PauLL54/PreamplifierAndMediaStreamer/Preamplifier.ino

// @title MIT License
//
//  Copyright © 2019 Paul Langemeijer. All rights reserved.
//
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
//  THE SOFTWARE IS PROVIDED "AS IS", WITHOUT WARRANTY OF ANY KIND, EXPRESS OR
//  IMPLIED, INCLUDING BUT NOT LIMITED TO THE WARRANTIES OF MERCHANTABILITY,
//  FITNESS FOR A PARTICULAR PURPOSE AND NONINFRINGEMENT. IN NO EVENT SHALL
//  THE AUTHORS OR COPYRIGHT HOLDERS BE LIABLE FOR ANY CLAIM, DAMAGES OR OTHER
//  LIABILITY, WHETHER IN AN ACTION OF CONTRACT, TORT OR OTHERWISE, ARISING
//  FROM, OUT OF OR IN CONNECTION WITH THE SOFTWARE OR THE USE OR OTHER
//  DEALINGS IN THE SOFTWARE.
#include <Wire.h>
#include "InputChannelSelector.h"
#include "InputChannelSelectButton.h"
#include "DigitalPotmeter.h"
#include "DigitalAttenuator.h"
#include "VolumeRotaryEncoder.h"
#include "IRCommands.h"
#include "SystemParameters.h"
#include "i2c.h"
#include "LightControl.h"
#include "OutputChannelSelector.h"

DigitalPotmeter m_digitalPotmeter;
DigitalAttenuator m_digitalAttenuator;
OutputChannelSelector m_outputChannelSelector(m_digitalAttenuator);
InputChannelSelector m_inputChannelSelector(m_digitalPotmeter, m_outputChannelSelector);
InputChannelSelectButton m_inputChannelSelectButton(m_inputChannelSelector);
VolumeRotaryEncoder m_volumeRotaryEncoder(m_digitalPotmeter);
IRCommands m_IRCommands(m_inputChannelSelector, m_digitalPotmeter);
I2C m_i2c(m_inputChannelSelector, m_digitalPotmeter, m_digitalAttenuator, m_outputChannelSelector, m_IRCommands);
LightControl m_lightControl(m_inputChannelSelectButton, m_volumeRotaryEncoder, m_IRCommands, m_digitalPotmeter, m_inputChannelSelector, m_i2c);

bool m_initializing = true;

#define INPUT_SIZE 30
void I2C_receiveEvent(int howMany)
{
  char input[INPUT_SIZE + 1];
  byte i = 0;
  while (Wire.available() > 0 && i < INPUT_SIZE)
  {
    char c = (char)Wire.read();
    input[i] = c;
    i++;
  }
  input[i] = (char)0;
  //Serial.println(input);
  m_i2c.handleInput(input);
}

void I2C_requestEvent()
{
  // send input channel (0..7), output channel (0..1), volume enabled for channel (byte: 0..255, each bit determines state of a channel), volume (0..31)
  char buf[20];
  sprintf(buf, "I=%d;O=%d;R=%3d;V=%2d;\0", 
    m_inputChannelSelector.getChannel(),  
    m_outputChannelSelector.getChannel(),
    m_IRCommands.getVolumeEnabledForChannel(),
    m_digitalPotmeter.getTargetValue());
    //Serial.println(buf);
    Wire.write(buf);
}

void setup()
{
  Serial.begin(9600);

  Wire.begin(4);                    // join i2c bus with address #4
  Wire.onReceive(I2C_receiveEvent); // register event
  Wire.onRequest(I2C_requestEvent);
}

void initializeDigitalPotmeters()
{
  m_digitalPotmeter.updateToTargetValue();
  m_digitalAttenuator.updateToTargetValue();
  if (m_digitalPotmeter.isInitialized())
  {
    m_initializing = false;
    m_digitalAttenuator.initChannelValues();
    m_digitalPotmeter.initChannelValues();

    m_inputChannelSelector.selectChannel(6);  // 0..7
    m_outputChannelSelector.selectChannel(0);  // 0..1
    m_outputChannelSelector.enableOutputs();
  }
}

void loop()
{
  if (m_initializing)
  {
    initializeDigitalPotmeters();
  }
  else
  {
    m_inputChannelSelectButton.checkButtonPressed();
    m_volumeRotaryEncoder.checkRotation();
    m_IRCommands.checkForCommands();
    m_digitalPotmeter.updateToTargetValue();
    m_digitalAttenuator.updateToTargetValue();
    m_lightControl.checkDisplaySwitchOffNeeded();
    m_inputChannelSelector.checkMuted();
  }
}
