PauLL54/PreamplifierAndMediaStreamer/InputChannelSelector.h

//  Copyright © 2019 Paul Langemeijer. All rights reserved.
#pragma once
#include "Debouncer.h"
#include "stdint.h"

class DigitalPotmeter;
class OutputChannelSelector;

class InputChannelSelector {
public:
	InputChannelSelector(DigitalPotmeter& digitalPotmeter, OutputChannelSelector& outputChannelSelector);

    int8_t getChannel();
	void selectChannel(int8_t channel); // 0..7
	void selectNextChannel();
	void selectPreviousChannel();
	void setDefaultBrightness(int8_t brightness);
	void enableDisplay();
	void disableDisplay();
	void checkMuted();

private:
	void setBrightness(int8_t brightness);
	void switchToChannel(int8_t channel);

private:
	DigitalPotmeter& m_digitalPotmeter;
	OutputChannelSelector& m_outputChannelSelector;
	int8_t m_brightness;
	int8_t m_currentChannel;
	unsigned long m_muteTimeOut;
};
