PauLL54/PreamplifierAndMediaStreamer/DigitalAttenuator.h

//  Copyright © 2019 Paul Langemeijer. All rights reserved.
#pragma once
#include "XicorX9514.h"

class DigitalAttenuator : public XicorX9514 {
public:
	DigitalAttenuator();

	void initChannelValues();
};
