PauLL54/PreamplifierAndMediaStreamer/(commit log)

2019-06-14 LedRing class
2019-06-17 Debouncer using millis()
2019-06-17 Keeping Led ring white
2019-06-17 LED ring green and white
2019-06-19 change pin led ring
2019-06-19 change bounce time encoder
2019-06-20 fix issue in debouncer
    [Debouncer.cpp, InputChannelSelectButton.cpp, VolumeRotaryEncoder.cpp]
2019-07-02 pin constants
2019-07-04 Enable output relay
2019-07-05 disable LED ring after 30 minutes
2019-11-02 Add support for I2C bus for version 2
2019-12-26 Shorten time light is on
    [LightControl.cpp]
2020-02-17 Prepare for PCB version 2
2020-03-08 Fix input selector LEDs display off
    [InputChannelSelector.cpp]
2020-03-10 Disable / enable display; prepare I2C
2020-03-11 I2C support LedBrightness
2020-07-21 I2C SetChannel
2020-07-24 LightControl adapted for I2C
2020-08-28 remove print statements
2020-09-02 support for diffrent rotary encoders
2020-10-01 fix issue in SCV command
    [InputChannelSelector.cpp, InputChannelSelector.h, OutputChannelSelector.cpp, OutputChannelSelector.h, Preamplifier.ino, XicorX9514.cpp, XicorX9514.h, i2c.cpp]
2020-10-04 PD6 used to determine encoder direction
2020-10-05 Don't show LED light when volume is changed but not enabled
2020-10-16 New Raspberry code for NodeRed
2020-11-07 On I2C request: also send volume
2020-11-07 I2C requestEvent: fix issue with ";"
    [Preamplifier.ino]
2020-11-07 Clear buffer in I2C_requestEvent
2020-11-07 Update Node-Red flow (volume slider)
2020-11-08 Update node-red flow
2020-11-08 Mute Bluetooth channel shortly to prevent clicks
    [InputChannelSelector.cpp, InputChannelSelector.h, OutputChannelSelector.cpp, OutputChannelSelector.h, Preamplifier.ino]
2020-11-09 Update node-red flow + remove print statements
